liquid-rocketry-illinois/flight-computer-one-hw/rocketrin-withouteyes.png

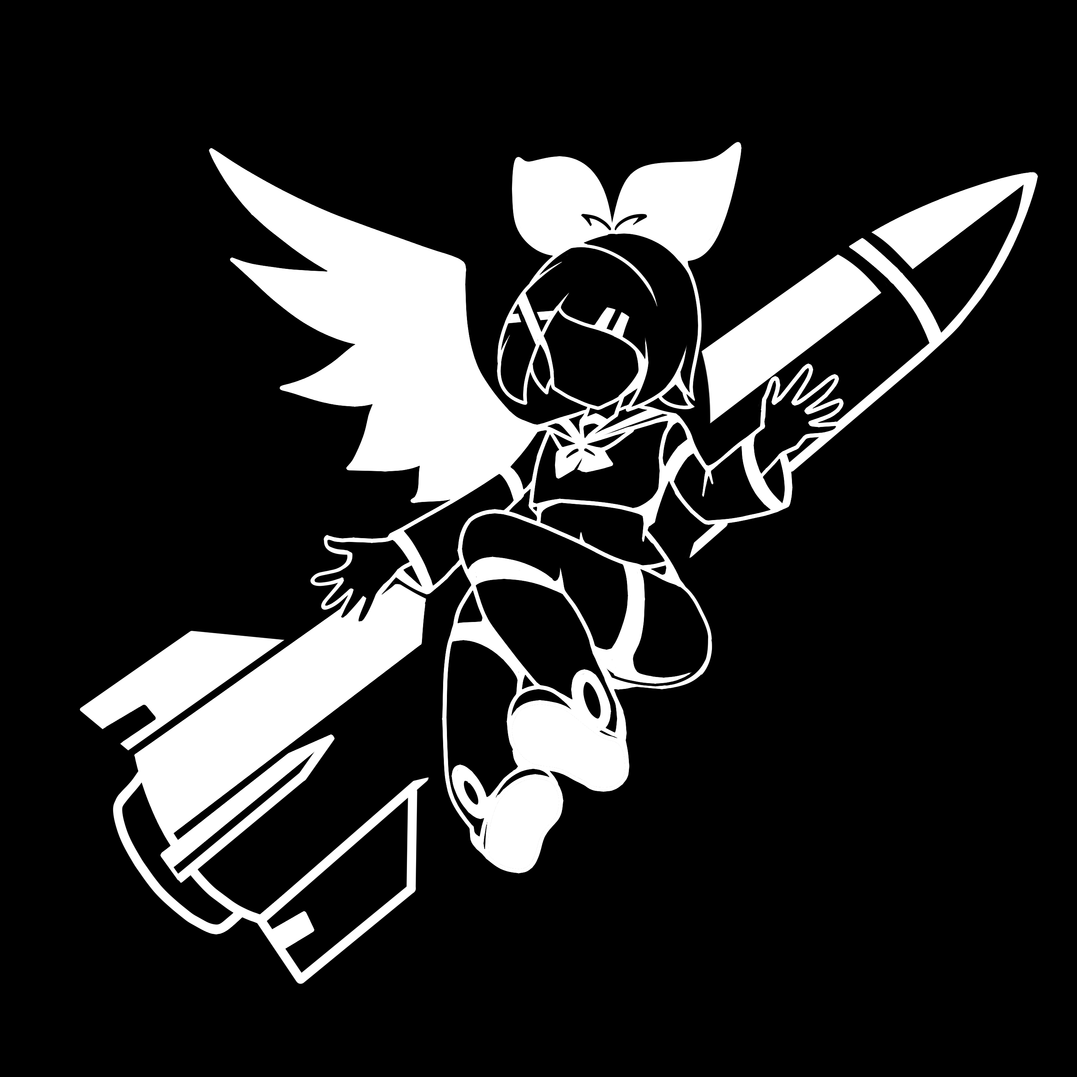
rocketrin-withouteyes.png
