liquid-rocketry-illinois/flight-computer-one-hw/(commit log)

2025-03-11 Copied over completed compute page
    [compute.kicad_sch]
2025-03-11 first gpg signed commit
    [networking.kicad_sch]
2025-03-11 Copy over sensor designs
    [sensors.kicad_sch]
2025-03-22 the beginnings of a footprint
    [compute.kicad_sch, connectivity.kicad_sch, flight-computer-one.kicad_pcb, flight-computer-one.kicad_sch, networking.kicad_sch, sensors.kicad_sch]
2025-03-22 created project lib
    [compute.kicad_sch, connectivity.kicad_sch, flight-computer-one.kicad_pcb, flight-computer-one.kicad_sch, power_usb.kicad_sch, sensors.kicad_sch, servo_pyro.kicad_sch]
2025-03-24 added gitignore
    [compute.kicad_sch, connectivity.kicad_sch, flight-computer-one.kicad_pcb, power_usb.kicad_sch, sensors.kicad_sch, servo_pyro.kicad_sch]
2025-03-25 Fixed BMI088 footprint and readme
    [connectivity.kicad_sch, flight-computer-one.kicad_pcb, power_usb.kicad_sch, sensors.kicad_sch, servo_pyro.kicad_sch]
2025-03-28 progress, particularly on power
    [compute.kicad_sch, flight-computer-one.kicad_pcb, power_usb.kicad_sch, servo_pyro.kicad_sch]
2025-03-30 nearly completed schematic, partial layout
    [connectivity.kicad_sch, flight-computer-one.kicad_pcb, flight-computer-one.kicad_sch, power_usb.kicad_sch, sensors.kicad_sch, servo_pyro.kicad_sch]
2025-04-06 schematic + prelim layout nearly complete
    [compute.kicad_sch, connectivity.kicad_sch, flight-computer-one.kicad_pcb, flight-computer-one.kicad_sch, power_usb.kicad_sch, sensors.kicad_sch, servo_pyro.kicad_sch]
2025-04-07 Schematic tentatively complete
    [compute.kicad_sch, connectivity.kicad_sch, flight-computer-one.kicad_pcb, flight-computer-one.kicad_sch, power_usb.kicad_sch, sensors.kicad_sch, servo_pyro.kicad_sch]
2025-04-08 schematic tentatively finished
    [compute.kicad_sch, connectivity.kicad_sch, flight-computer-one.kicad_pcb, flight-computer-one.kicad_sch, power_usb.kicad_sch, sensors.kicad_sch, servo_pyro.kicad_sch]
2025-04-14 swapped POR chip for TPS2121
    [compute.kicad_sch, connectivity.kicad_sch, flight-computer-one.kicad_pcb, power_usb.kicad_sch]
2025-04-17 added pictures to readme
    [flight-computer-one.kicad_pcb, power_usb.kicad_sch]
